finik/sink-buddy/renders/smiley_2_front.png

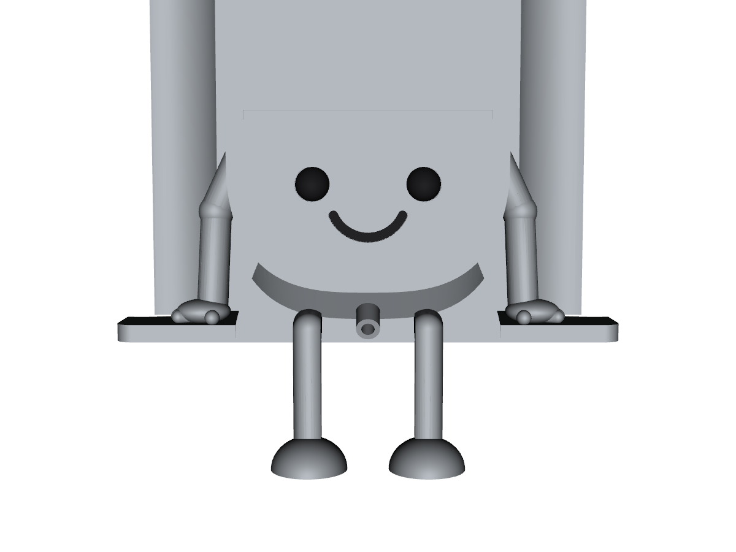
renders/smiley_2_front.png
