finik/sink-buddy/renders/smiley_3_front_sponge.png

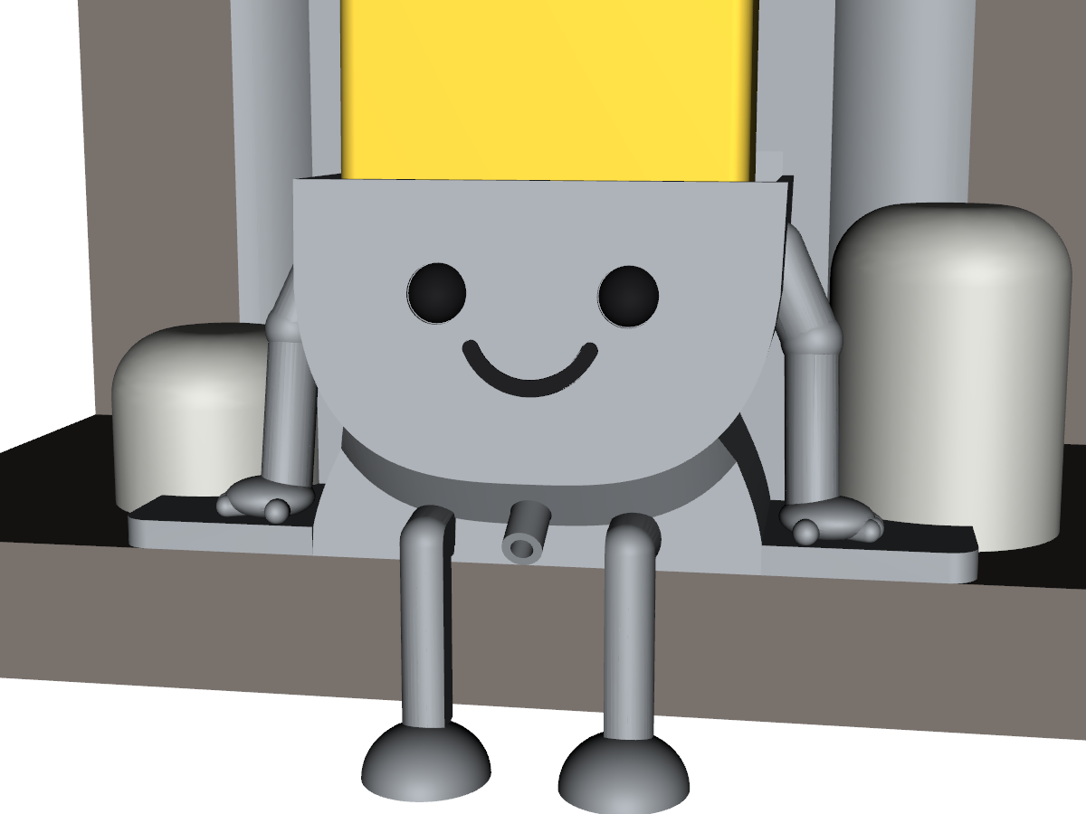
renders/smiley_3_front_sponge.png
