finik/sink-buddy/renders/smiley_4_top.png

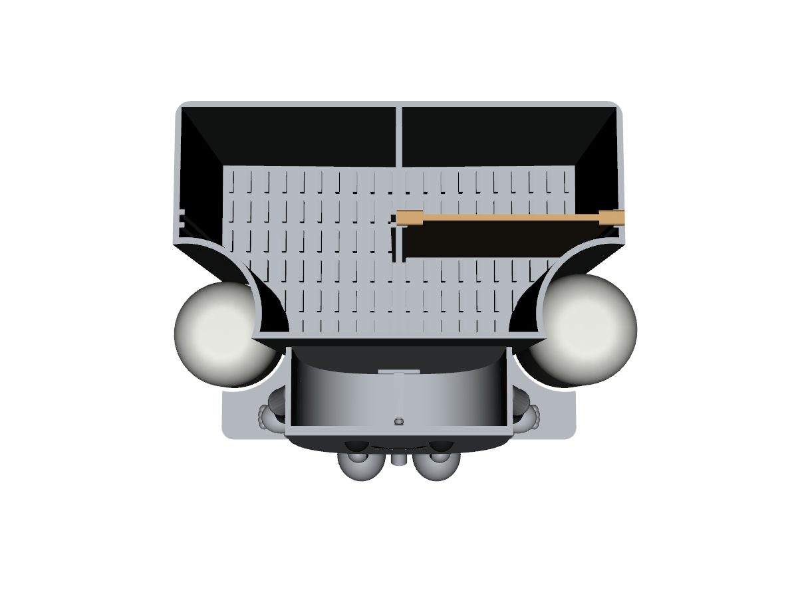
renders/smiley_4_top.png
