finik/sink-buddy/renders/smiley_5_side.png

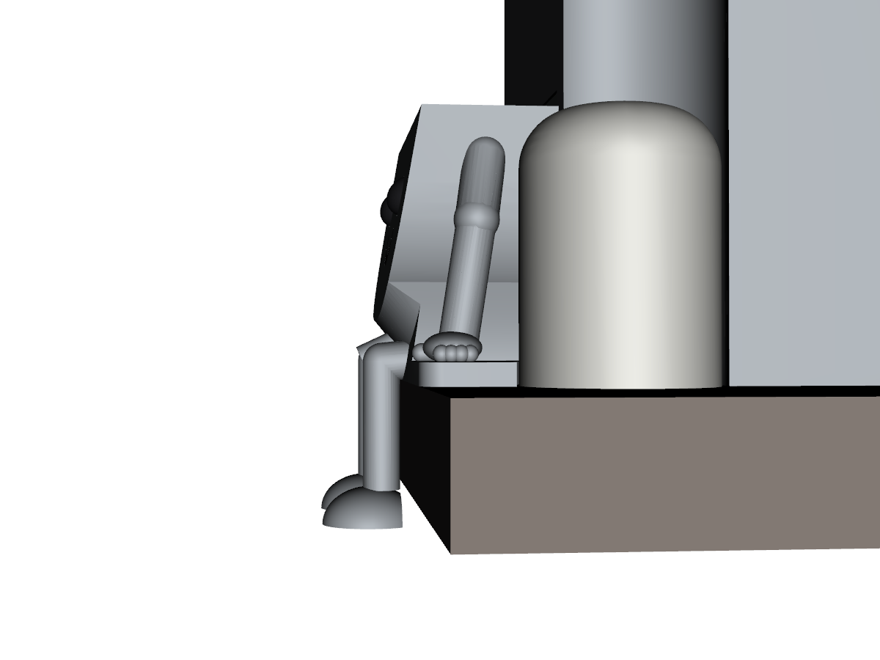
renders/smiley_5_side.png
