finik/sink-buddy/renders/smiley_6_legs.png

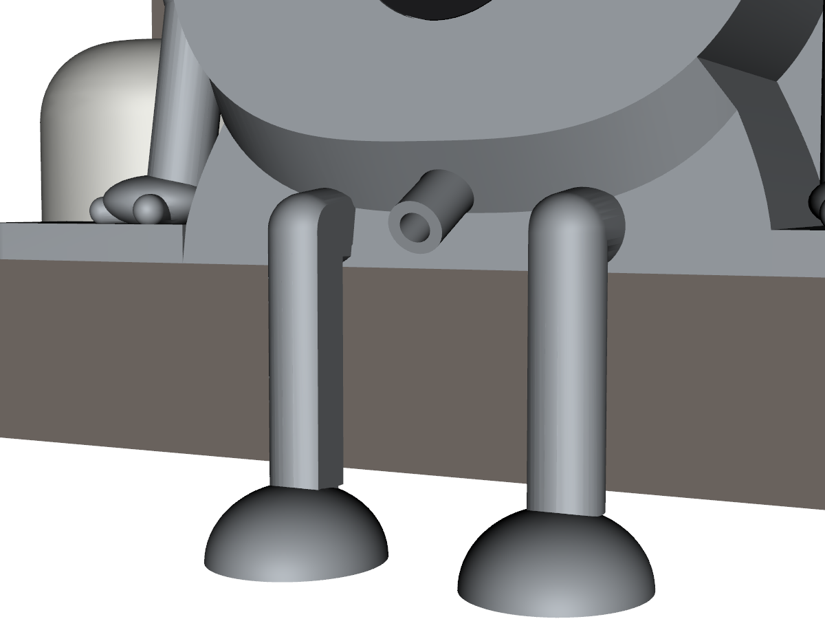
renders/smiley_6_legs.png
