finik/sink-buddy/package/smiley_smile.stl

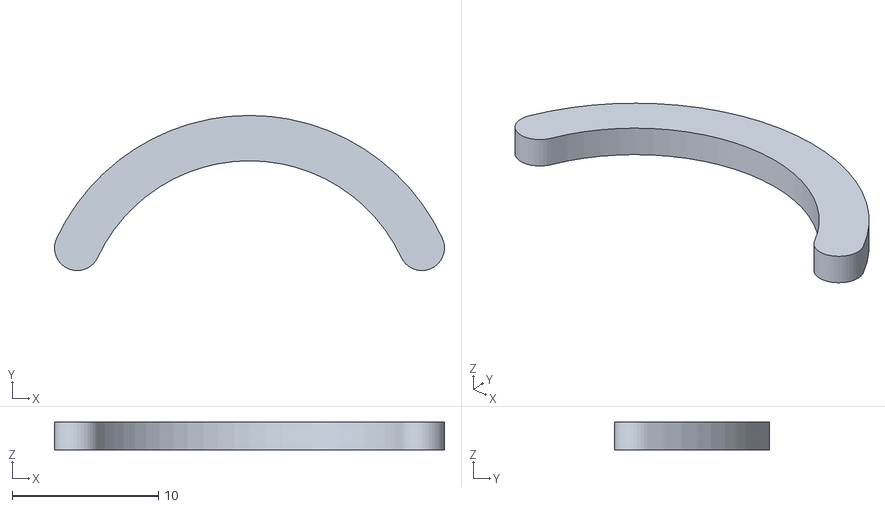
[picture p11: CAD file, 2026-11-02]
package/smiley_smile.stl
26.7 x 10.6 x 1.90
