finik/sink-buddy/package/smiley_divider.stl

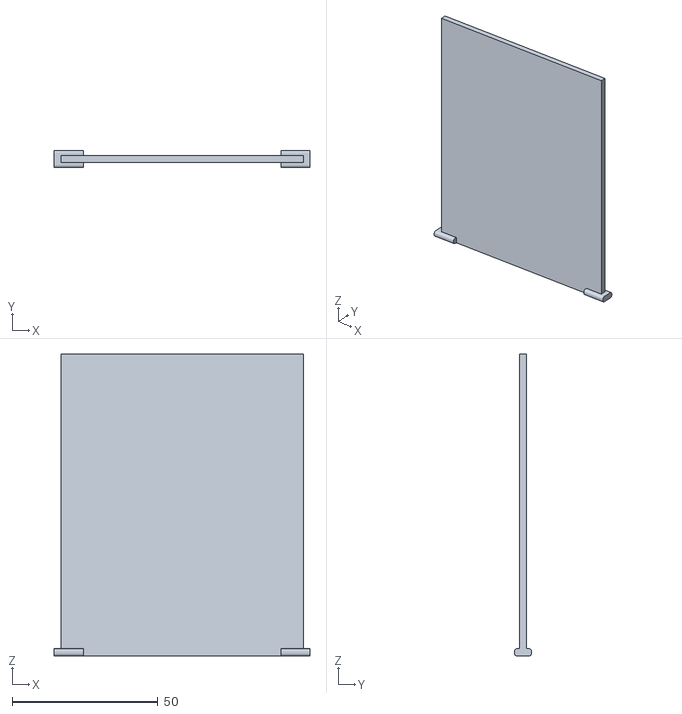
[picture p12: CAD file, 2026-11-02]
package/smiley_divider.stl
87.8 x 6.00 x 103.6
