finik/sink-buddy/package/smiley_leg_right.stl

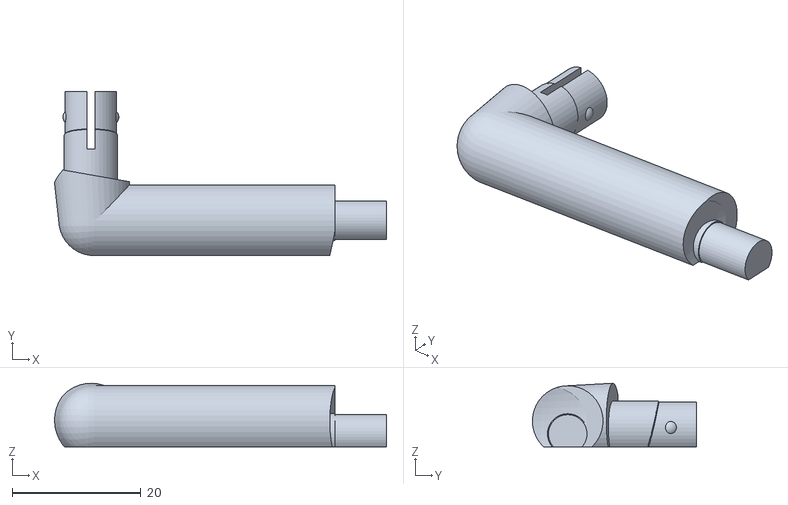
[picture p13: CAD file, 2026-11-02]
package/smiley_leg_right.stl
51.7 x 25.6 x 9.89
