finik/sink-buddy/package/smiley_eyes.stl

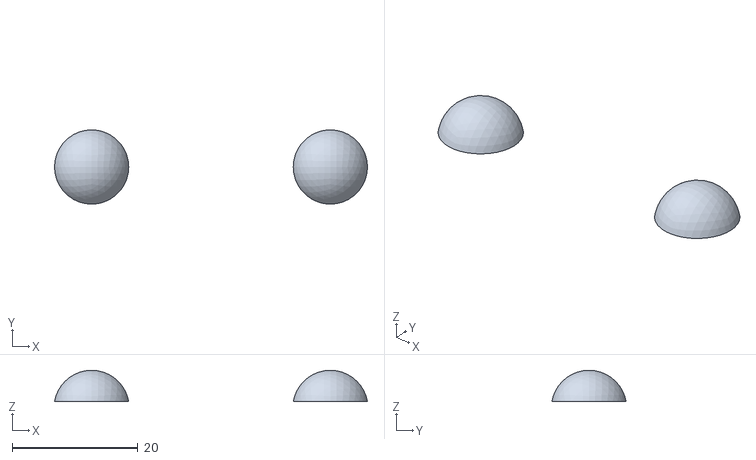
[picture p14: CAD file, 2026-11-02]
package/smiley_eyes.stl
49.8 x 11.8 x 5.00
