finik/sink-buddy/package/smiley_spout.stl

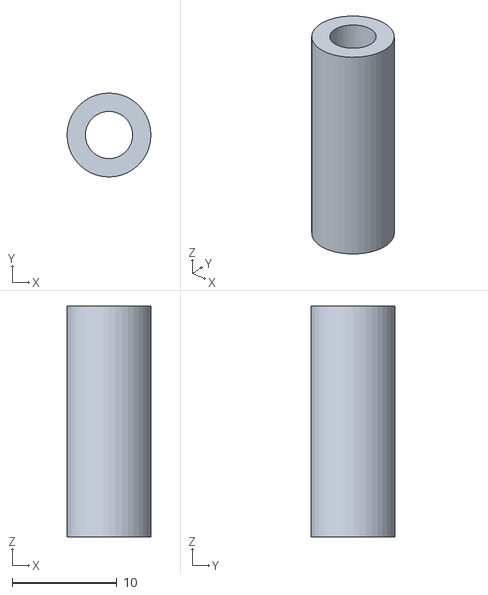
[picture p15: CAD file, 2026-11-02]
package/smiley_spout.stl
8.00 x 8.00 x 22.0
