finik/sink-buddy/package/smiley_body.stl

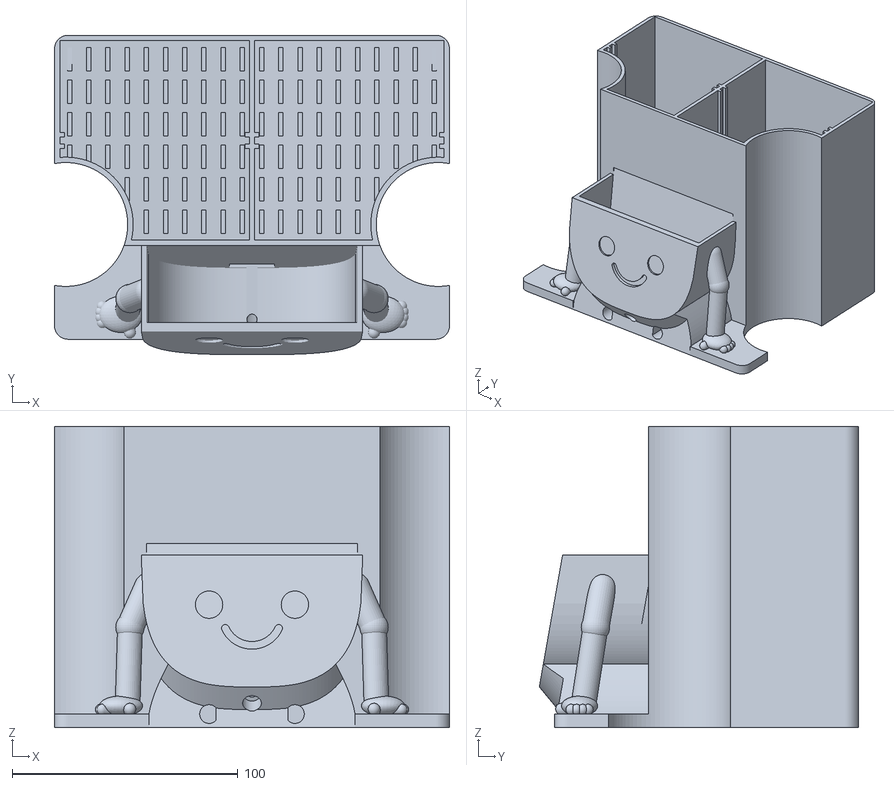
[picture p16: CAD file, 2026-11-02]
package/smiley_body.stl
174.8 x 141.3 x 133.3
