finik/sink-buddy/package/smiley_base_test.stl

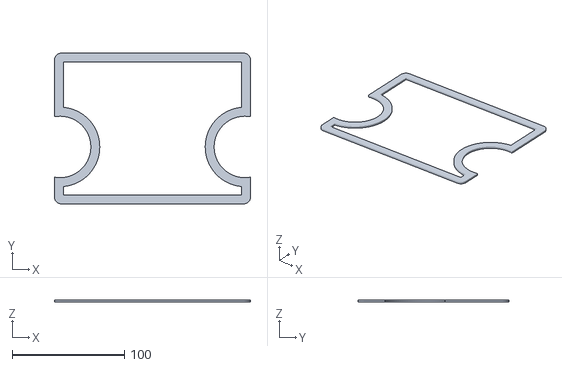
[picture p17: CAD file, 2026-11-02]
package/smiley_base_test.stl
174.8 x 134.5 x 2.00
