finik/sink-buddy/package/smiley_foot_right.stl

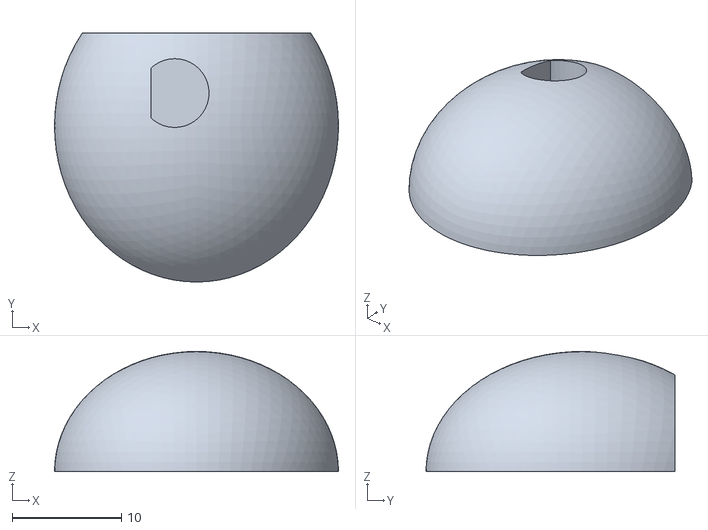
[picture p18: CAD file, 2026-11-02]
package/smiley_foot_right.stl
26.0 x 22.8 x 11.0
