finik/sink-buddy/(list of files, cad)

Other CAD files:
package/smiley_leg_left.stl
package/smiley_foot_left.stl
